yavor0/Nerf-Turret/README.md

# Nerf-Turret
[Презентация](https://docs.google.com/presentation/d/1fLrgsliyY0jNuQwyysKF2oRUAvKUPr7-/edit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)
