yavor0/Nerf-Turret/Nerf Turret/server_side/arduino_communication.py

import serial


class com_ard():
    def __init__(self, parent):
        self.parent = parent
        print("ard created")


    def connect(self, port):
        try:
            self.ser = serial.Serial(port, 9600)
            self.parent.connected = True
            print("connected to arduino on port : ", port)
            return True
        except Exception as e:
            print("Not able to connect on this port")
            print(e)
            return False

    def send_message(self, message):
        self.ser.write(message)
        print(message)
