yavor0/Nerf-Turret/(commit log)

2023-04-17 disabled button images
2023-04-22 Better performance and non-crash closing added
    [Nerf_turret_pc.py]
2023-04-22 arduino code updated
2023-04-23 reverted to old version
    [Nerf_turret_pc.py, code.ino]
